PenguinOwl/effect-pedal/Core/Inc/lvgl/src/drivers/README.md

High level drivers for display controllers, frame buffers, etc
