PenguinOwl/effect-pedal/case/effect-pedal - bottom.stl

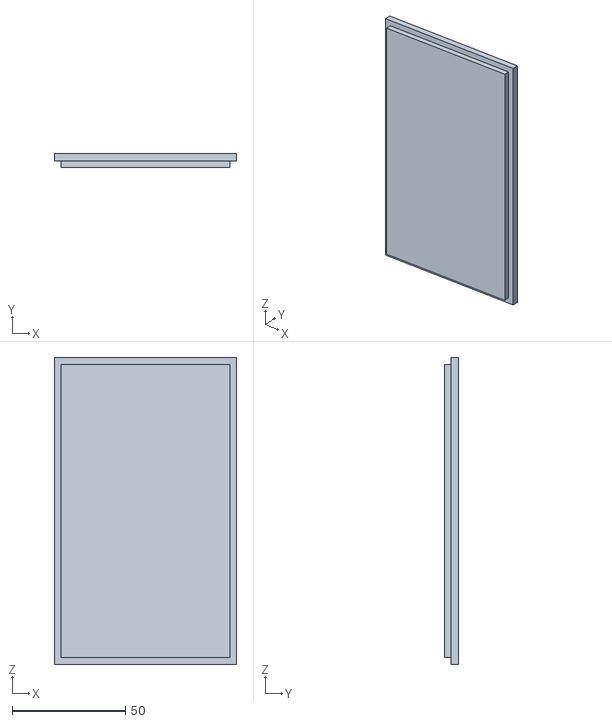
[picture p1: CAD file, 2026-03-07]
case/effect-pedal - bottom.stl
80.5 x 6.38 x 135.7
