PenguinOwl/effect-pedal/kicad-stomp/Models/User Library-Footswich_3PDT.step

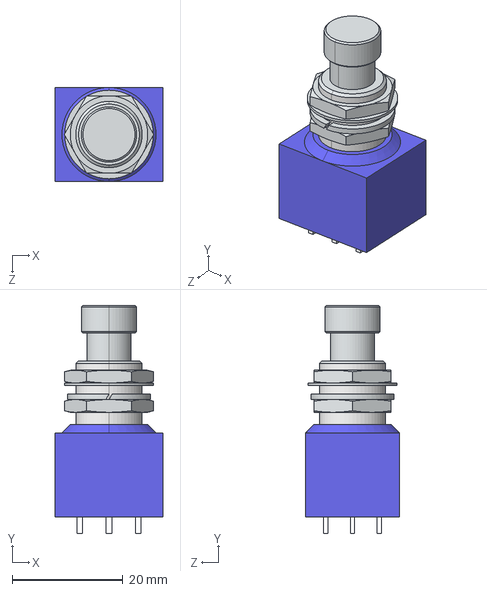
[picture p2: CAD file, 2026-02-17]
kicad-stomp/Models/User Library-Footswich_3PDT.step
19.6 x 41.2 x 17.0 mm
