PenguinOwl/effect-pedal/kicad/effect-pedal.step

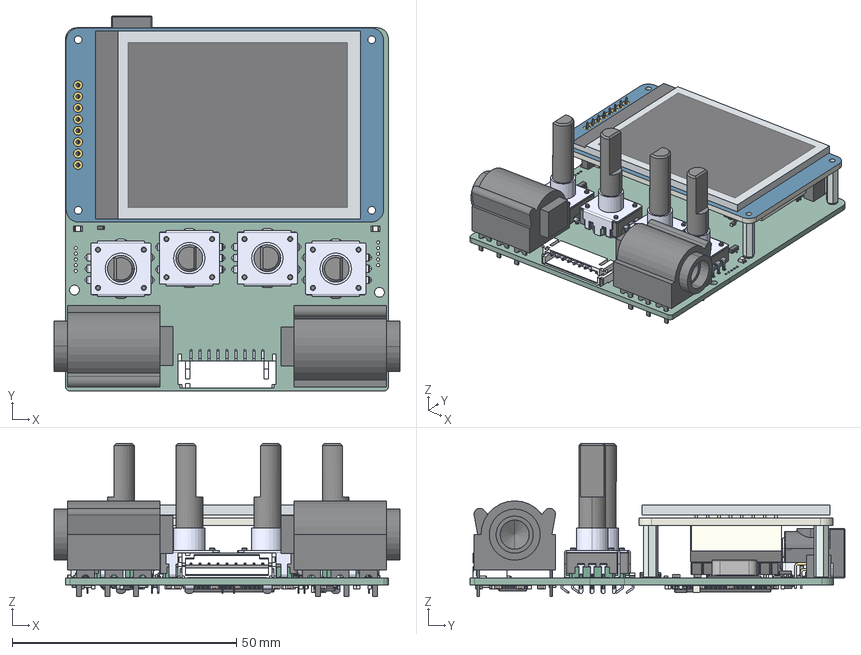
[picture p3: CAD file, 2026-03-07]
kicad/effect-pedal.step
77.1 x 83.6 x 34.2 mm
R_0603_1608Metric x 21
PJ-002AH-SMT-TR_v2
USB4110-GF-A
C_0603_1608Metric x 40
SOT-23 x 2
nmj6hcd3_v2 x 2
SxB-PH-SM4-TB white_9
PEC12R-4230F-S0024 x 4
LED_0805_2012Metric x 2
Crystal_SMD_HC49-SD
20021522-00014xxlfc_v2
SOT-23-6
PinHeader_1x08_P2.54mm_Vertical_SMD_Pin1Right
PinSocket_1x08_P2.54mm_Vertical
TSSOP-20_4.4x6.5mm_P0.65mm
D_SOD-323F x 2
TSOT-23 x 2
LQFP-144_20x20mm_P0.5mm
SOT-23-5
L_1206_3216Metric
BODY-QFN
PIN1-ID
effect-pedal_PCB
