PenguinOwl/effect-pedal/kicad/Models/Same_Sky_TS04-66-65-BK-260-SMT.step

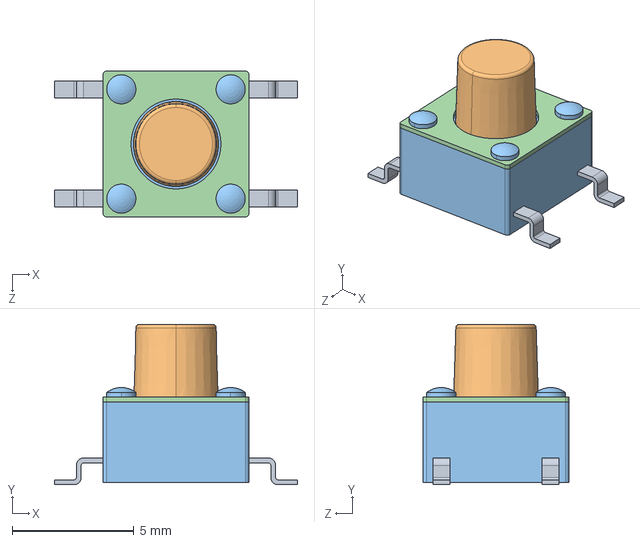
[picture p4: CAD file, 2026-02-21]
kicad/Models/Same_Sky_TS04-66-65-BK-260-SMT.step
10.0 x 6.60 x 6.00 mm
