PenguinOwl/effect-pedal/case/effect-pedal -top.stl

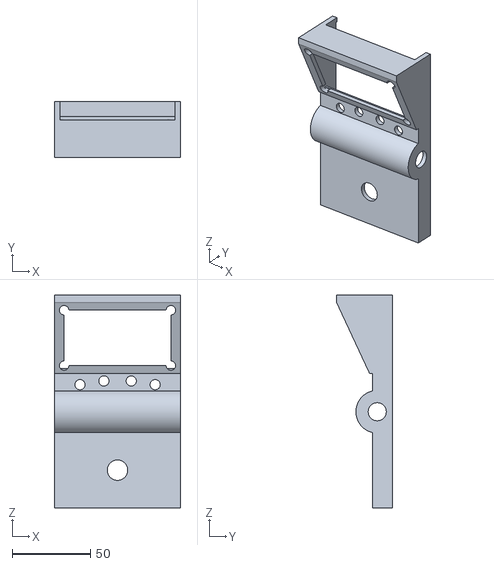
[picture p5: CAD file, 2026-03-07]
case/effect-pedal -top.stl
80.5 x 35.7 x 135.7
