PenguinOwl/effect-pedal/kicad/Models/USB4110-GF-A.stp

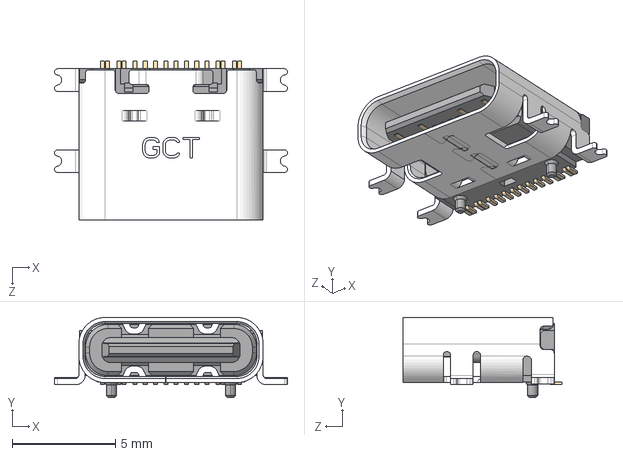
[picture p6: CAD file, 2026-02-20]
kicad/Models/USB4110-GF-A.stp
11.3 x 3.89 x 7.70 mm
