PenguinOwl/effect-pedal/kicad/Models/K01-004K01-2.step

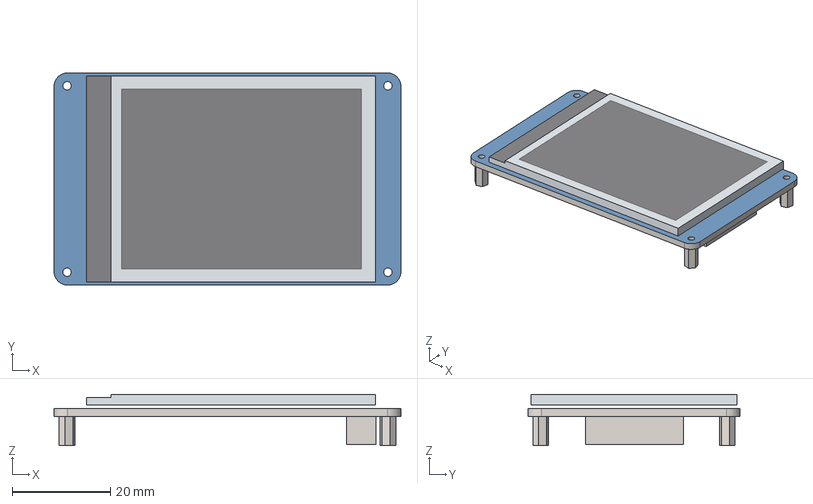
[picture p7: CAD file, 2026-02-20]
kicad/Models/K01-004K01-2.step
70.8 x 43.3 x 10.5 mm
