PenguinOwl/effect-pedal/kicad/Models/nmj6hcd3_v2.stp

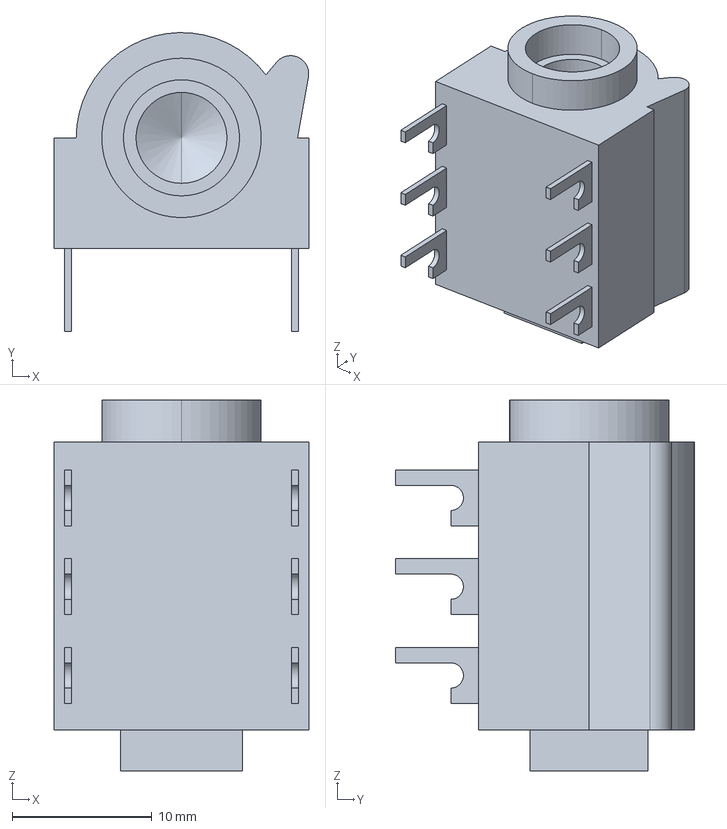
[picture p8: CAD file, 2026-02-20]
kicad/Models/nmj6hcd3_v2.stp
18.2 x 21.4 x 26.5 mm
