PenguinOwl/effect-pedal/kicad/Models/S9B-PH-SM4-TB.STEP

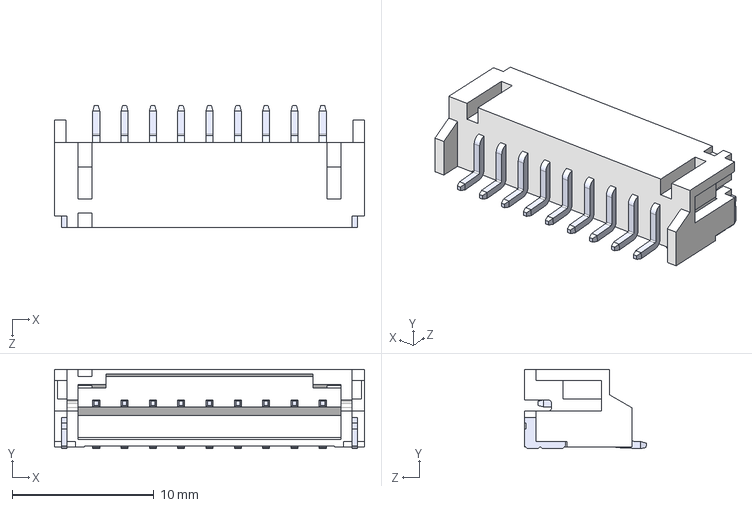
[picture p9: CAD file, 2026-02-20]
kicad/Models/S9B-PH-SM4-TB.STEP
21.9 x 5.60 x 8.60 mm
