PenguinOwl/effect-pedal/kicad/Models/PJ-002AH-SMT-TR_v2.step

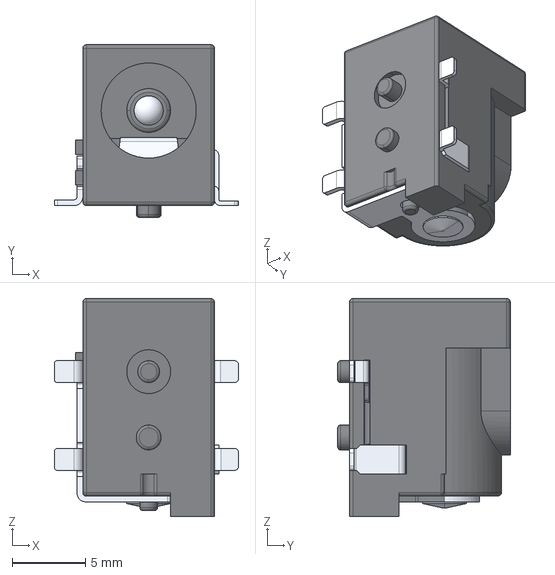
[picture p11: CAD file, 2026-02-20]
kicad/Models/PJ-002AH-SMT-TR_v2.step
12.6 x 11.8 x 14.9 mm
