PenguinOwl/effect-pedal/kicad/Models/PEC12R-4230F-S0024.STEP

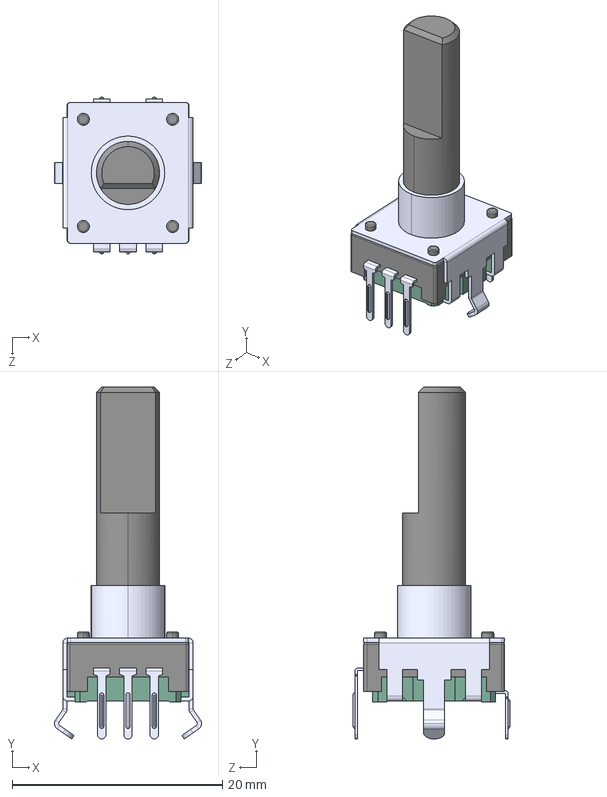
[picture p12: CAD file, 2026-02-20]
kicad/Models/PEC12R-4230F-S0024.STEP
14.0 x 33.5 x 14.9 mm
