PenguinOwl/effect-pedal/kicad/Models/FTSH-107-01-L-DV-K-A.stp

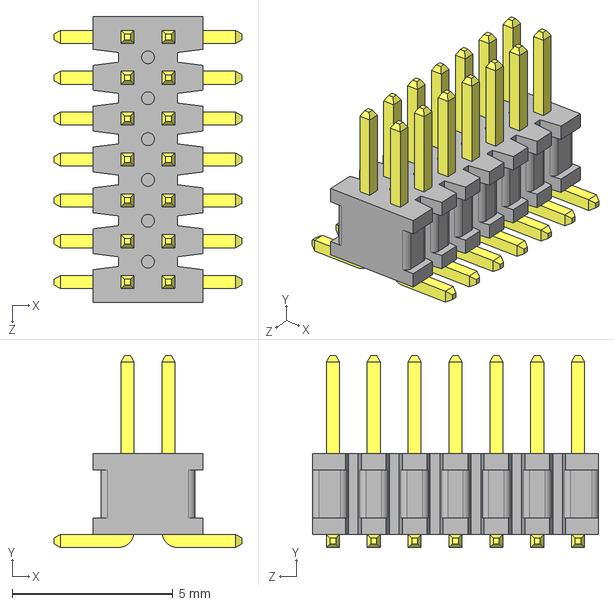
[picture p13: CAD file, 2026-02-19]
kicad/Models/FTSH-107-01-L-DV-K-A.stp
5.84 x 5.97 x 8.89 mm
