PenguinOwl/effect-pedal/kicad/Models/PEC11L-4125F-S0020.stp

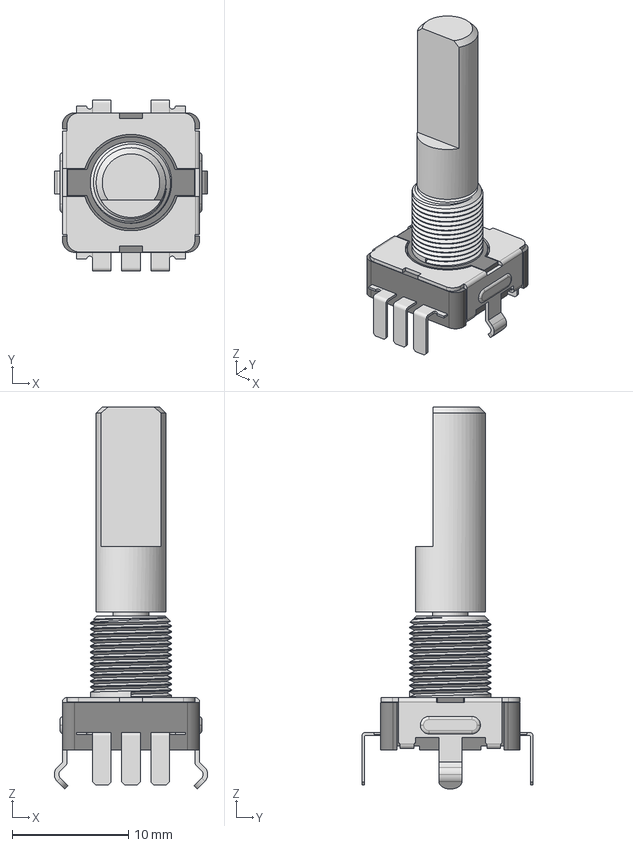
[picture p14: CAD file, 2026-02-18]
kicad/Models/PEC11L-4125F-S0020.stp
13.2 x 14.8 x 32.9 mm
