PenguinOwl/effect-pedal/kicad/Models/PEC12R-4225F-S0024.stp

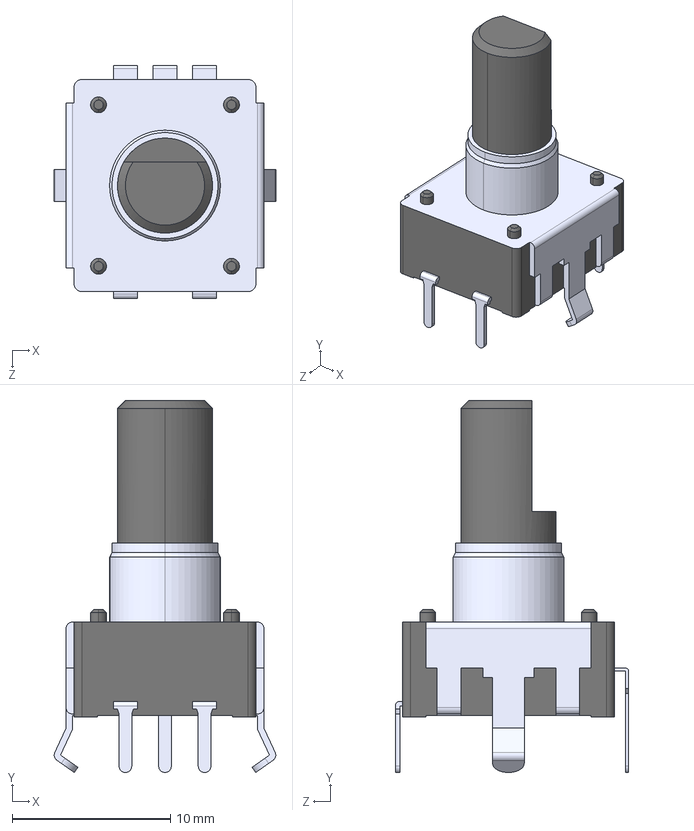
[picture p15: CAD file, 2026-02-18]
kicad/Models/PEC12R-4225F-S0024.stp
14.0 x 23.5 x 14.7 mm
