PenguinOwl/effect-pedal/kicad/Models/PEC11L-4115F-S0020.stp

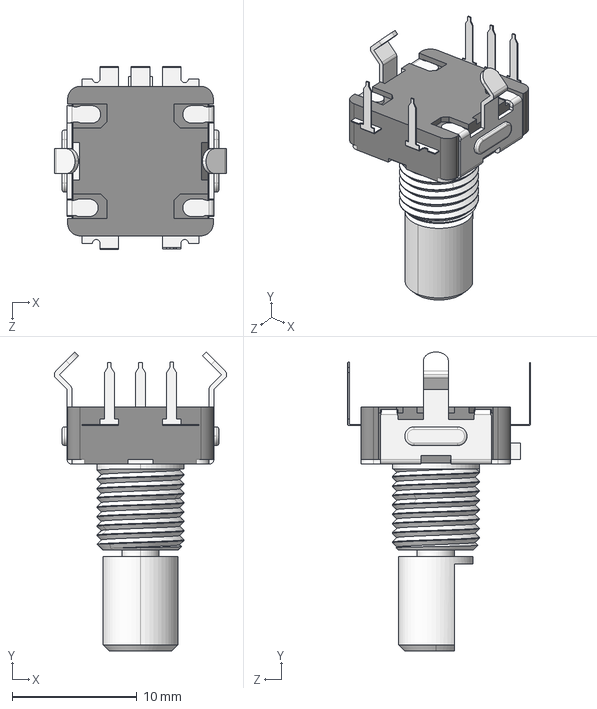
[picture p16: CAD file, 2026-02-17]
kicad/Models/PEC11L-4115F-S0020.stp
13.8 x 24.0 x 14.7 mm
