PenguinOwl/effect-pedal/kicad/Models/PJ-002A.step

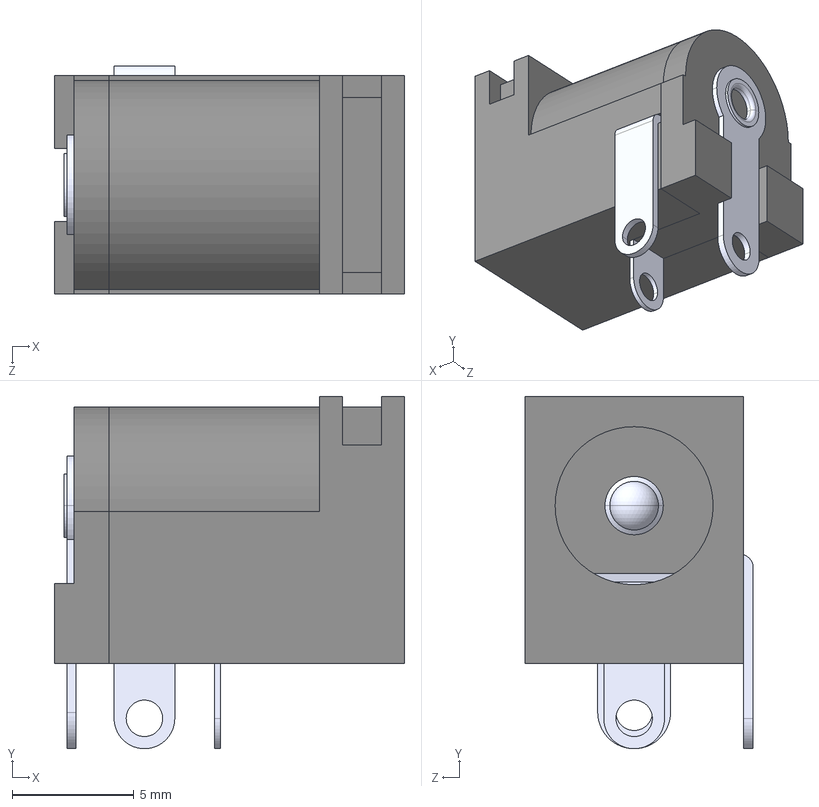
[picture p17: CAD file, 2026-02-17]
kicad/Models/PJ-002A.step
14.4 x 14.5 x 9.40 mm
