PenguinOwl/effect-pedal/(list of files, cad)

Other CAD files:
kicad/Models/nmj6hcd3.stp
kicad/Models/k01-2.stp
kicad/Models/20021522-00014xxlfc.stp
kicad/Models/20021522-00014xxlfc_v2.stp
kicad/Models/PJ-002AH-SMT-TR.step
kicad/Models/TPS62140ARGTR.stp
