PenguinOwl/effect-pedal/kicad/effect-pedal.pdf

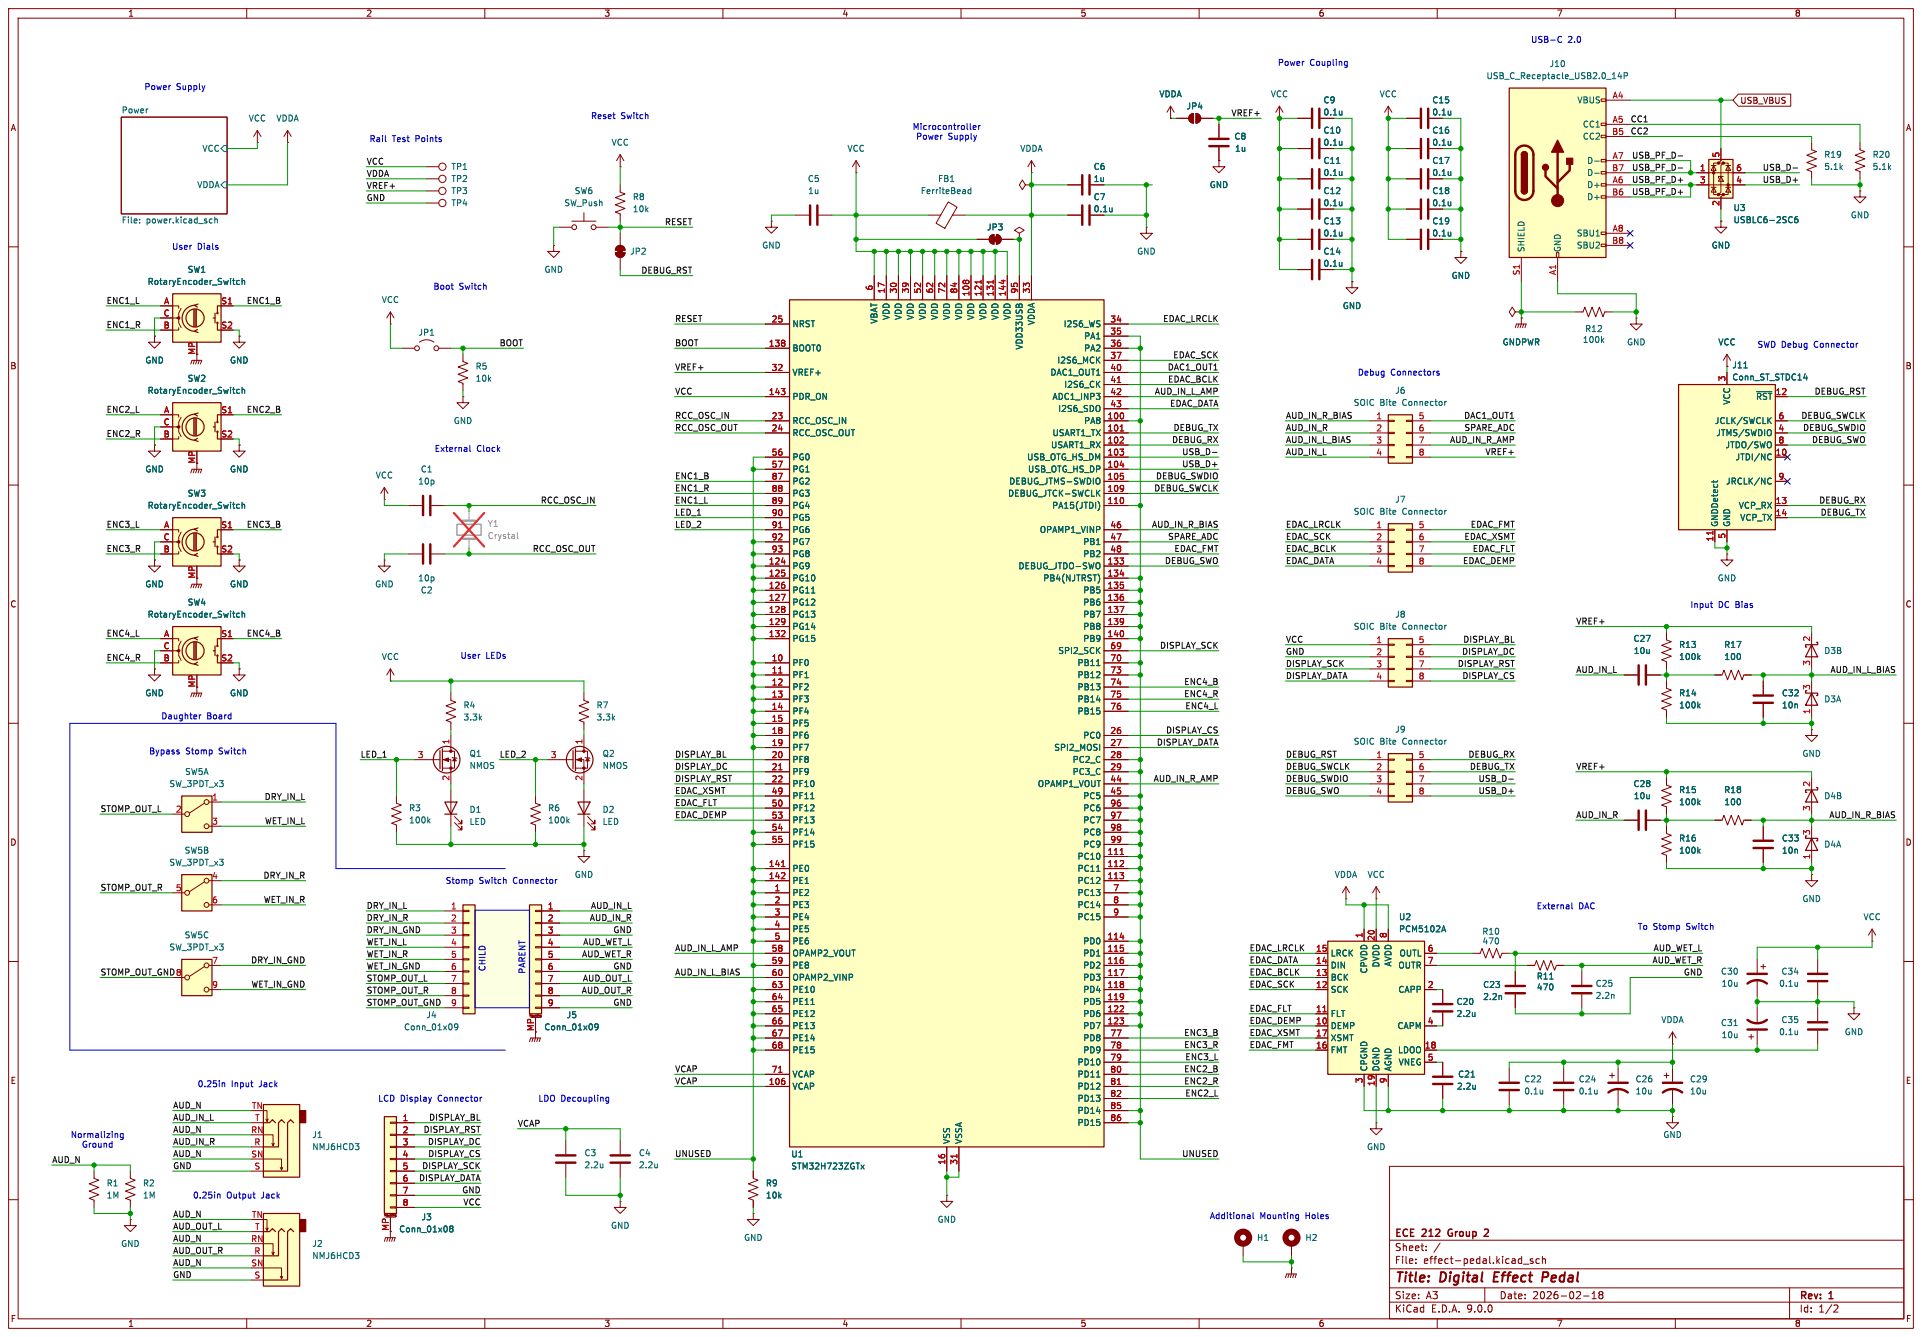
[picture p18: page 1]

Power Supply User Dials
Power File: power.kicad_sch

6 VDD 17 VDD 30 VDD 39 VDD 52 VDD 62 VDD 72 VSS 16 VDD 84 VSSA 31 VDD 108 VDD 121 VDD 131 VDD 144 VDD33USB 95 VDDA 33

J8 SOIC Bite Connector GND

VCC
J9 SOIC Bite Connector GND

9 OUTL 6 OUTR 7 CAPP 2 CAPM 4

Id: 1/2 Title: Digital Effect Pedal File: effect-pedal.kicad_sch Sheet: / ECE 212 Group 2

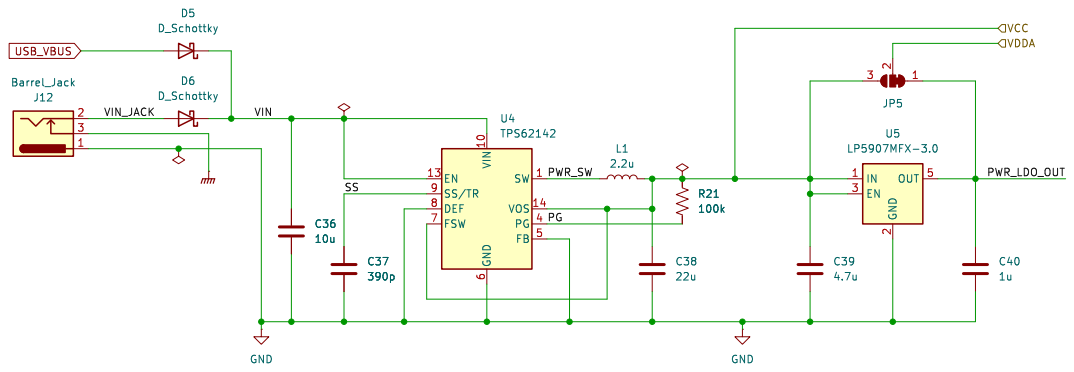
[picture p19: page 2]

6 SW 1 VOS 14 PG 4 FB 5 U4 TPS62142 GND

Id: 2/2 Title: Digital Effect Pedal File: power.kicad_sch Sheet: /Power/ ECE 212 Group 2
