PenguinOwl/effect-pedal/kicad/effect-pedal.kicad_pcb

## KiCad design kicad/effect-pedal.kicad_pcb (2026-03-07)

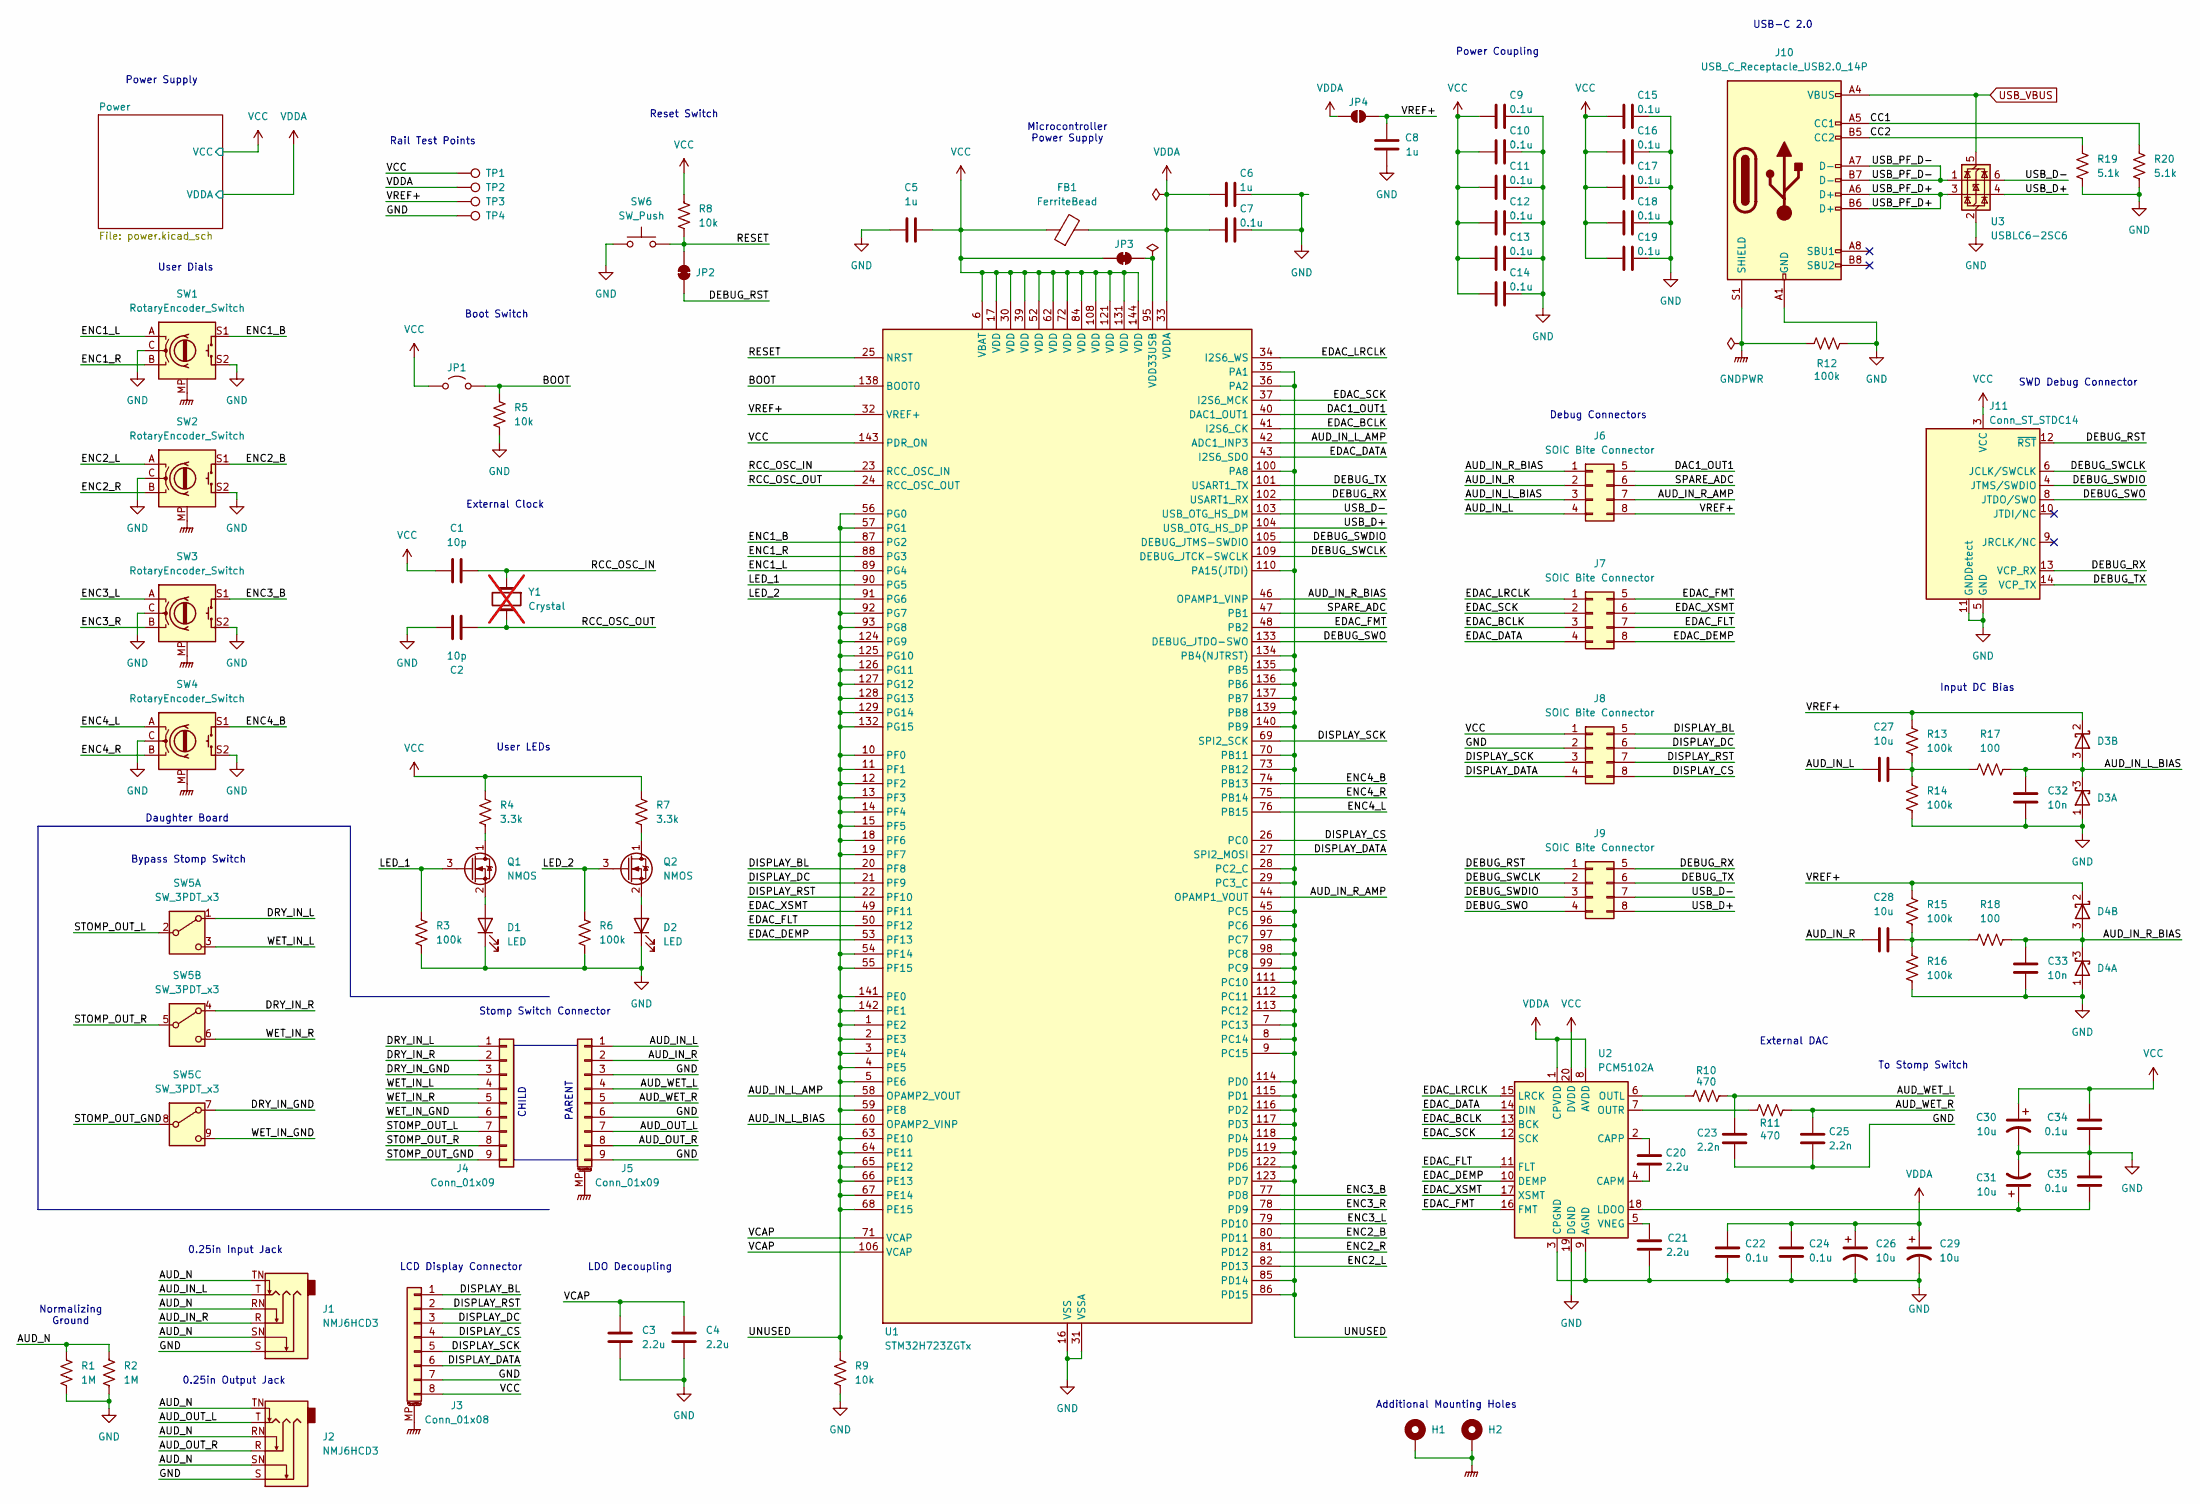
[picture p20: schematic effect-pedal.kicad_sch, Digital Effect Pedal]

Parts:
C1, C2: 10p; C_0603_1608Metric; Part KGM15ACG1E100KT
C3, C4, C20, C21: 2.2u; C_0603_1608Metric; Part Generic
C5, C6, C8: 1u; C_0603_1608Metric; Part Generic
C7, C9, C10, C11, C12, C13, C14, C15, C16, C17, C18, C19, C22, C24, C34, C35: 0.1u; C_0603_1608Metric; Part CL10B104KO8NNNC
C23, C25: 2.2n; C_0603_1608Metric; Part Generic
C26, C27, C28, C29, C30, C31: 10u; C_0603_1608Metric; Part Generic
C32, C33: 10n; C_0603_1608Metric; Part HMJ107BB7103KAHT
D1, D2: LED; LED_0805_2012Metric; Part LTST-C170KRKT
D3, D4: D_Schottky_Dual_Series_ACK_Split; TSOT-23; Part BAT54SFILM
FB1: FerriteBead; L_1206_3216Metric; Part CZP2BFTTE601P
H1, H2: MountingHole_Pad; MountingHole_2.2mm_M2_ISO7380_Pad
J1, J2: NMJ6HCD3; Jack_6.35mm_Neutrik_NMJ6HCD3_Horizontal; Part NMJ6HCD3
J3: Conn_01x08; Waveshare_2.4in_LCD; Part 10129380-908001BLF
J4: Conn_01x09; JST_XH_S9B-XH-A_1x09_P2.50mm_Horizontal; Part Generic
J5: Conn_01x09; JST_PH_S9B-PH-SM4-TB_1x09-1MP_P2.00mm_Horizontal; Part S9B-PH-SM4-TB
J6, J7, J8, J9: SOIC Bite Connector; SOIC_clipProgSmall; Part Generic
J10: USB_C_Receptacle_USB2.0_14P; USB_C_Receptacle_GCT_USB4110; Part USB4110-GF-A
J11: Conn_ST_STDC14; STDC14_Connector; Part 20021512-00014T1LF
JP1: Jumper_2_Open; TestPoint_2Pads_Pitch2.54mm_Drill0.8mm
JP2, JP3: SolderJumper_2_Bridged; SolderJumper-2_P1.3mm_Bridged2Bar_RoundedPad1.0x1.5mm
JP4: SolderJumper_2_Open; SolderJumper-2_P1.3mm_Open_TrianglePad1.0x1.5mm
Q1, Q2: NMOS; SOT-23; Part IRLML6344TRPBF
R1, R2: 1M; R_0603_1608Metric; Part Generic
R3, R6, R12, R13, R14, R15, R16: 100k; R_0603_1608Metric; Part Generic
R4, R7: 3.3k; R_0603_1608Metric; Part Generic
R5, R8, R9: 10k; R_0603_1608Metric; Part Generic
R10, R11: 470; R_0603_1608Metric; Part Generic
R17, R18: 100; R_0603_1608Metric; Part Generic
R19, R20: 5.1k; R_0603_1608Metric; Part Generic
SW1, SW2, SW3, SW4: RotaryEncoder_Switch; RotaryEncoder_Bourns_Vertical_PEC12R-3x17F-Sxxxx; Part PEC12R-4225F-S0024
SW5: SW_3PDT_x3
SW6: SW_Push; SW_Push_1P1T_NO_E-Switch_TL3301NxxxxxG; Part TS04-66-65-BK-260-SMT
TP1, TP2, TP3, TP4: TestPoint; TestPoint_Pad_2.0x2.0mm
U1: STM32H723ZGTx; LQFP-144_20x20mm_P0.5mm; Part STM32H723ZGT6
U2: PCM5102A; TSSOP-20_4.4x6.5mm_P0.65mm; Part PCM5102AQPWRQ1
U3: USBLC6-2SC6; SOT-23-6; Part USBLC6-2SC6
Y1: Crystal; Crystal_SMD_HC49-SD; not fitted

Connections:
/AUD_IN_L: C27.1, J1.T, J5.1, J6.4
/AUD_IN_L_AMP: U1.42 (ADC1_INP3), U1.58 (OPAMP2_VOUT)
/AUD_IN_L_BIAS: C32.2, D3.3 (K), J6.3, R17.2, U1.60 (OPAMP2_VINP)
/AUD_IN_R: C28.1, J1.R, J5.2, J6.2
/AUD_IN_R_AMP: J6.7, U1.44 (OPAMP1_VOUT)
/AUD_IN_R_BIAS: C33.2, D4.3 (K), J6.1, R18.2, U1.46 (OPAMP1_VINP)
/AUD_N: J1.RN, J1.SN, J1.TN, J2.RN, J2.SN, J2.TN, R1.1, R2.1
/AUD_OUT_L: J2.T, J5.7
/AUD_OUT_R: J2.R, J5.8
/AUD_WET_L: C23.2, J5.4, R10.1
/AUD_WET_R: C25.2, J5.5, R11.1
/BOOT: JP1.2 (B), R5.1, U1.138 (BOOT0)
/CC1: J10.A5 (CC1), R20.1
/CC2: J10.B5 (CC2), R19.1
/DAC1_OUT1: J6.5, U1.40 (DAC1_OUT1)
/DEBUG_RST: J9.1, J11.12 (~RST), JP2.1 (A)
/DEBUG_RX: J9.5, J11.13 (VCP_RX), U1.102 (USART1_RX)
/DEBUG_SWCLK: J9.2, J11.6 (JCLK/SWCLK), U1.109 (DEBUG_JTCK-SWCLK)
/DEBUG_SWDIO: J9.3, J11.4 (JTMS/SWDIO), U1.105 (DEBUG_JTMS-SWDIO)
/DEBUG_SWO: J9.4, J11.8 (JTDO/SWO), U1.133 (DEBUG_JTDO-SWO)
/DEBUG_TX: J9.6, J11.14 (VCP_TX), U1.101 (USART1_TX)
/DISPLAY_BL: J3.1, J8.5, U1.20 (PF8)
/DISPLAY_CS: J3.4, J8.8, U1.26 (PC0)
/DISPLAY_DATA: J3.6, J8.4, U1.27 (SPI2_MOSI)
/DISPLAY_DC: J3.3, J8.6, U1.21 (PF9)
/DISPLAY_RST: J3.2, J8.7, U1.22 (PF10)
/DISPLAY_SCK: J3.5, J8.3, U1.69 (SPI2_SCK)
/EDAC_BCLK: J7.3, U1.41 (I2S6_CK), U2.13 (BCK)
/EDAC_DATA: J7.4, U1.43 (I2S6_SDO), U2.14 (DIN)
/EDAC_DEMP: J7.8, U1.53 (PF13), U2.10 (DEMP)
/EDAC_FLT: J7.7, U1.50 (PF12), U2.11 (FLT)
/EDAC_FMT: J7.5, U1.48 (PB2), U2.16 (FMT)
/EDAC_LRCLK: J7.1, U1.34 (I2S6_WS), U2.15 (LRCK)
/EDAC_SCK: J7.2, U1.37 (I2S6_MCK), U2.12 (SCK)
/EDAC_XSMT: J7.6, U1.49 (PF11), U2.17 (XSMT)
/ENC1_B: SW1.S1, U1.87 (PG2)
/ENC1_L: SW1.A, U1.89 (PG4)
/ENC1_R: SW1.B, U1.88 (PG3)
/ENC2_B: SW2.S1, U1.80 (PD11)
/ENC2_L: SW2.A, U1.82 (PD13)
/ENC2_R: SW2.B, U1.81 (PD12)
/ENC3_B: SW3.S1, U1.77 (PD8)
/ENC3_L: SW3.A, U1.79 (PD10)
/ENC3_R: SW3.B, U1.78 (PD9)
/ENC4_B: SW4.S1, U1.74 (PB13)
/ENC4_L: SW4.A, U1.76 (PB15)
/ENC4_R: SW4.B, U1.75 (PB14)
/LED_1: Q1.3 (G), R3.1, U1.90 (PG5)
/LED_2: Q2.3 (G), R6.1, U1.91 (PG6)
/RCC_OSC_IN: C1.2, U1.23 (RCC_OSC_IN), Y1.1
/RCC_OSC_OUT: C2.1, U1.24 (RCC_OSC_OUT), Y1.2
/RESET: JP2.2 (B), R8.2, SW6.2, U1.25 (NRST)
/SPARE_ADC: J6.6, U1.47 (PB1)
/UNUSED: R9.1, U1.1 (PE2), U1.2 (PE3), U1.3 (PE4), U1.4 (PE5), U1.5 (PE6), U1.7 (PC13), U1.8 (PC14), U1.9 (PC15), U1.10 (PF0), U1.11 (PF1), U1.12 (PF2), U1.13 (PF3), U1.14 (PF4), U1.15 (PF5), U1.18 (PF6), U1.19 (PF7), U1.28 (PC2_C), U1.29 (PC3_C), U1.35 (PA1), U1.36 (PA2), U1.45 (PC5), U1.54 (PF14), U1.55 (PF15), U1.56 (PG0), U1.57 (PG1), U1.59 (PE8), U1.63 (PE10), U1.64 (PE11), U1.65 (PE12), U1.66 (PE13), U1.67 (PE14), U1.68 (PE15), U1.70 (PB11), U1.73 (PB12), U1.85 (PD14), U1.86 (PD15), U1.92 (PG7), U1.93 (PG8), U1.96 (PC6), U1.97 (PC7), U1.98 (PC8), U1.99 (PC9), U1.100 (PA8), U1.110 (PA15(JTDI)), U1.111 (PC10), U1.112 (PC11), U1.113 (PC12), U1.114 (PD0), U1.115 (PD1), U1.116 (PD2), U1.117 (PD3), U1.118 (PD4), U1.119 (PD5), U1.122 (PD6), U1.123 (PD7), U1.124 (PG9), U1.125 (PG10), U1.126 (PG11), U1.127 (PG12), U1.128 (PG13), U1.129 (PG14), U1.132 (PG15), U1.134 (PB4(NJTRST)), U1.135 (PB5), U1.136 (PB6), U1.137 (PB7), U1.139 (PB8), U1.140 (PB9), U1.141 (PE0), U1.142 (PE1)
/USB_D+: J9.8, U1.104 (USB_OTG_HS_DP), U3.4 (I/O2)
/USB_D-: J9.7, U1.103 (USB_OTG_HS_DM), U3.6 (I/O1)
/USB_PF_D+: J10.A6 (D+), J10.B6 (D+), U3.3 (I/O2)
/USB_PF_D-: J10.A7 (D-), J10.B7 (D-), U3.1 (I/O1)
/VCAP: C3.1, C4.1, U1.71 (VCAP), U1.106 (VCAP)
/VREF+: C8.2, D3.2 (K), D4.2 (K), J6.8, JP4.2 (B), R13.1, R15.1, TP3.1, U1.32 (VREF+)
GND: C2.2, C3.2, C4.2, C5.2, C6.2, C7.2, C8.1, C9.2, C10.2, C11.2, C12.2, C13.2, C14.2, C15.2, C16.2, C17.2, C18.2, C19.2, C21.1, C22.2, C23.1, C24.2, C25.1, C26.2, C29.2, C30.2, C31.2, C32.1, C33.1, C34.2, C35.1, D1.1 (K), D2.1 (K), D3.1 (A), D4.1 (A), J1.S, J2.S, J3.7, J5.3, J5.6, J5.9, J8.2, J10.A1 (GND), J10.A12 (GND), J10.B1 (GND), J10.B12 (GND), J11.5 (GND), J11.7 (GND), J11.11 (GNDDetect), R1.2, R2.2, R3.2, R5.2, R6.2, R9.2, R12.2, R14.2, R16.2, R19.2, R20.2, SW1.C, SW1.S2, SW2.C, SW2.S2, SW3.C, SW3.S2, SW4.C, SW4.S2, SW6.1, TP4.1, U1.16 (VSS), U1.31 (VSSA), U1.38 (VSS), U1.51 (VSS), U1.61 (VSS), U1.83 (VSS), U1.94 (VSS), U1.107 (VSS), U1.120 (VSS), U1.130 (VSS), U2.3 (CPGND), U2.9 (AGND), U2.19 (DGND), U3.2 (GND); also elsewhere on the board
GNDPWR: H1.1, H2.1, J3.MP (MountPin), J5.MP (MountPin), J10.S1 (SHIELD), R12.1, SW1.MP, SW2.MP, SW3.MP, SW4.MP; also elsewhere on the board
unnamed: C27.2, R13.2, R14.1, R17.1
unnamed: C28.2, R15.2, R16.1, R18.1
unnamed: D1.2 (A), Q1.2 (S)
unnamed: D2.2 (A), Q2.2 (S)
unnamed: J4.1, SW5.1 (A)
unnamed: J4.2, SW5.4 (A)
unnamed: J4.3, SW5.7 (A)
unnamed: J4.4, SW5.3 (C)
unnamed: J4.5, SW5.6 (C)
unnamed: J4.6, SW5.9 (C)
unnamed: J4.7, SW5.2 (B)
unnamed: J4.8, SW5.5 (B)
unnamed: J4.9, SW5.8 (B)
unnamed: JP3.2 (B), U1.95 (VDD33USB)
unnamed: Q1.1 (D), R4.2
unnamed: Q2.1 (D), R7.2
unnamed: C20.1, U2.4 (CAPM)
unnamed: C20.2, U2.2 (CAPP)
unnamed: C31.1, C35.2, U2.18 (LDOO)
unnamed: R10.2, U2.6 (OUTL)
unnamed: R11.2, U2.7 (OUTR)
unnamed: C21.2, U2.5 (VNEG)
USB_VBUS: J10.A4 (VBUS), J10.A9 (VBUS), J10.B4 (VBUS), J10.B9 (VBUS), U3.5 (VBUS); also elsewhere on the board
VCC: C1.1, C5.1, C9.1, C10.1, C11.1, C12.1, C13.1, C14.1, C15.1, C16.1, C17.1, C18.1, C19.1, C30.1, C34.1, FB1.1, J3.8, J8.1, J11.3 (VCC), JP1.1 (A), JP3.1 (A), R4.1, R7.1, R8.1, TP1.1, U1.6 (VBAT), U1.17 (VDD), U1.30 (VDD), U1.39 (VDD), U1.52 (VDD), U1.62 (VDD), U1.72 (VDD), U1.84 (VDD), U1.108 (VDD), U1.121 (VDD), U1.131 (VDD), U1.143 (PDR_ON), U1.144 (VDD), U2.20 (DVDD); also elsewhere on the board
VDDA: C6.1, C7.1, C22.1, C24.1, C26.1, C29.1, FB1.2, JP4.1 (A), TP2.1, U1.33 (VDDA), U2.1 (CPVDD), U2.8 (AVDD); also elsewhere on the board

Notes on the sheet:
Normalizing Ground
Input DC Bias
CHILD
Microcontroller Power Supply
Boot Switch
SWD Debug Connector
Additional Mounting Holes
Power Supply
External DAC
Stomp Switch Connector
Debug Connectors
PARENT
LCD Display Connector
0.25in Input Jack
Daughter Board
USB-C 2.0
Reset Switch
To Stomp Switch
External Clock
LDO Decoupling
User Dials
0.25in Output Jack
Bypass Stomp Switch
Power Coupling
User LEDs
Rail Test Points

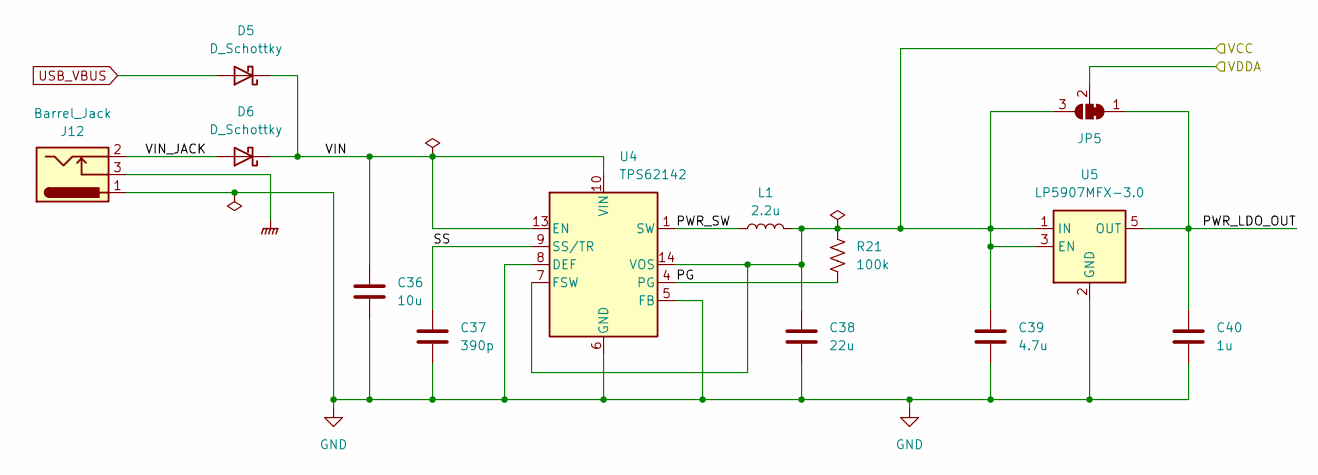
[picture p21: schematic power.kicad_sch, Digital Effect Pedal]

Parts:
C36: 10u; C_0603_1608Metric; Part Generic
C37: 390p; C_0603_1608Metric; Part C0603C391J5GAC
C38: 22u; C_0603_1608Metric; Part KAM21AT70J226KU
C39: 4.7u; C_0603_1608Metric; Part C1608X7S0G475M080AC
C40: 1u; C_0603_1608Metric; Part Generic
D5, D6: D_Schottky; D_SOD-323F; Part GSGP0240SD
J12: Barrel_Jack; CUI_PJ-002AH-SMT-TR; Part PJ-002AH-SMT-TR
JP5: SolderJumper_3_Bridged12; SolderJumper-3_P1.3mm_Bridged12_Pad1.0x1.5mm
L1: 2.2u; L_Vishay_IHLP-1212; Part MPX1D1250L2R2
R21: 100k; R_0603_1608Metric; Part Generic
U4: TPS62142; VQFN-16-1EP_3x3mm_P0.5mm_EP1.68x1.68mm_ThermalVias; Part TPS62142RGTR
U5: LP5907MFX-3.0; SOT-23-5; Part LP5907MFX-3.0

Connections:
/Power/PG: R21.2, U4.4 (PG)
/Power/PWR_LDO_OUT: C40.1, JP5.1 (A), U5.5 (OUT)
/Power/PWR_SW: L1.1, U4.1 (SW), U4.2 (SW), U4.3 (SW)
/Power/SS: C37.1, U4.9 (SS/TR)
/Power/VIN: C36.1, D5.1 (K), D6.1 (K), U4.10 (VIN), U4.11 (VIN), U4.12 (VIN), U4.13 (EN)
/Power/VIN_JACK: D6.2 (A), J12.2
GND: C36.2, C37.2, C38.2, C39.2, C40.2, J12.1, U4.5 (FB), U4.6 (GND), U4.8 (DEF), U4.15 (GND), U4.16 (GND), U4.17 (GND), U5.2 (GND); also elsewhere on the board
GNDPWR: J12.3; also elsewhere on the board
USB_VBUS: D5.2 (A); also elsewhere on the board
VCC: C38.1, C39.1, JP5.3 (B), L1.2, R21.1, U4.7 (FSW), U4.14 (VOS), U5.1 (IN), U5.3 (EN); also elsewhere on the board
VDDA: JP5.2 (C); also elsewhere on the board

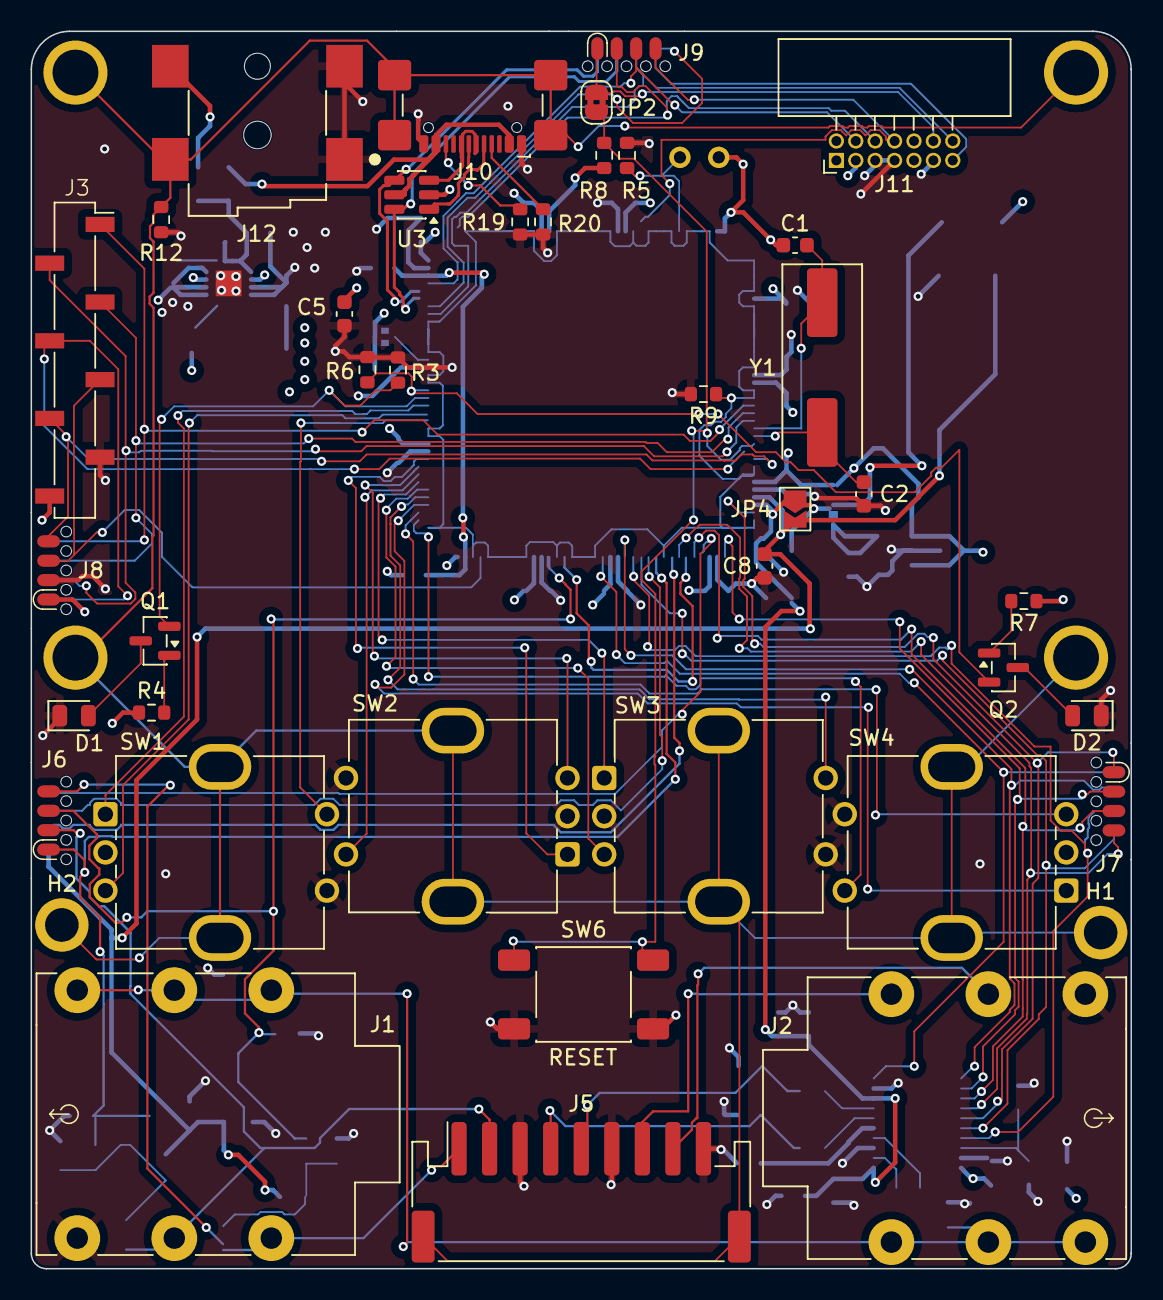
[picture p22: board effect-pedal.kicad_pcb from above]

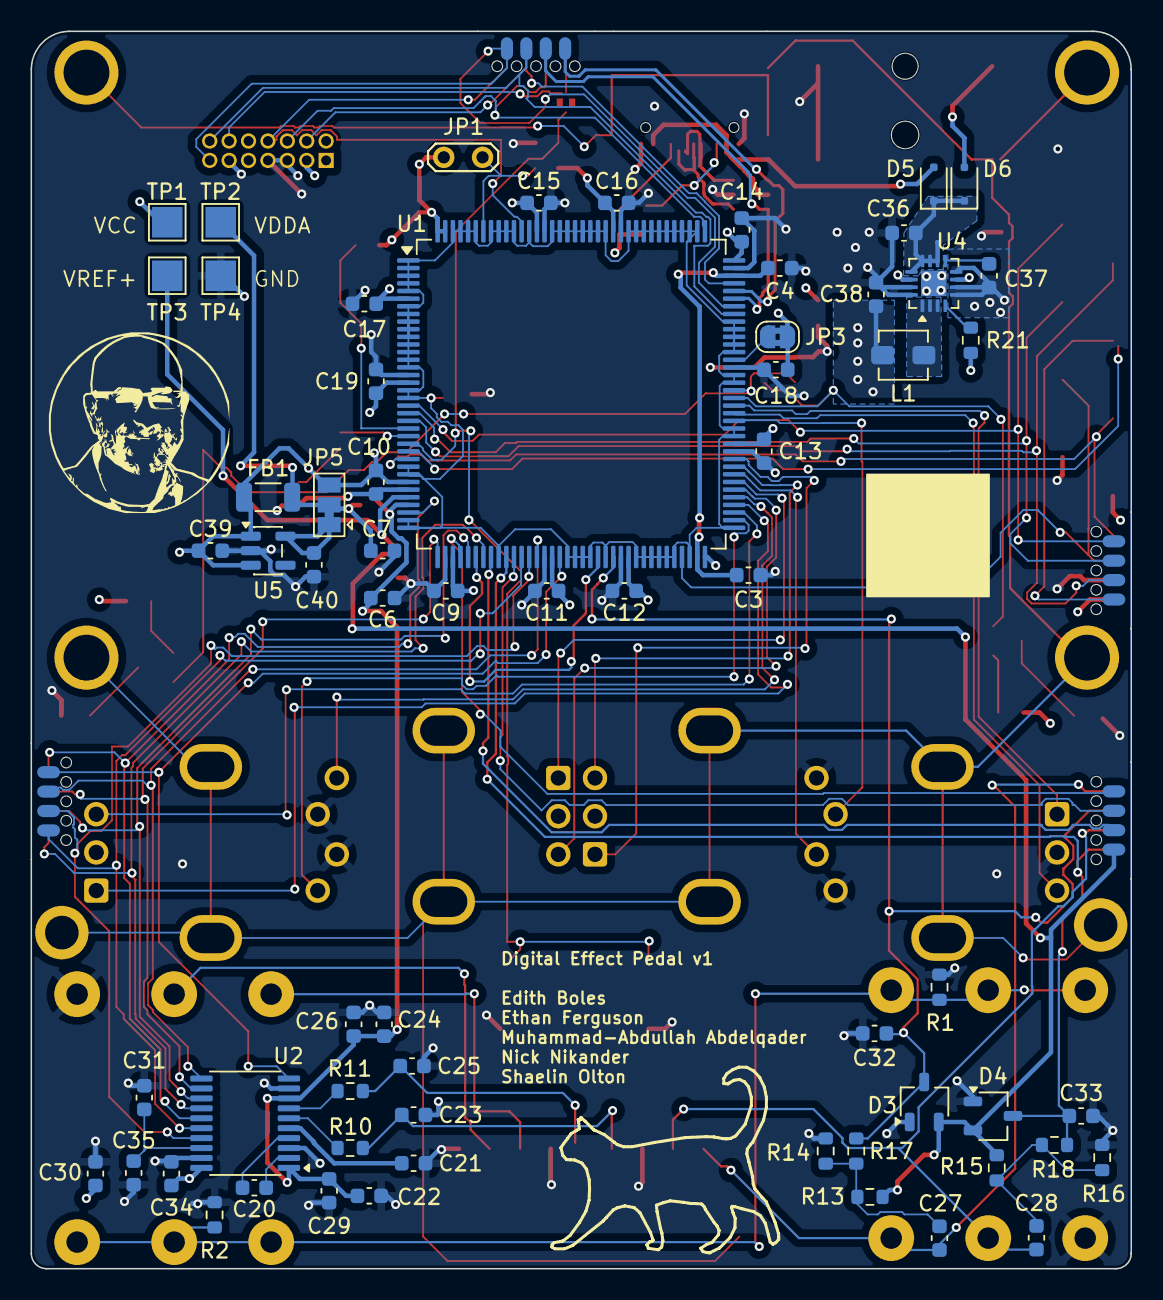
[picture p23: board effect-pedal.kicad_pcb from below]

Board: 4 copper layers, 72.0 x 81.0 mm, 104 parts (64 on the bottom side), 84 nets.
