PenguinOwl/effect-pedal/Core/Src/main.c

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
/* Includes ------------------------------------------------------------------*/
#include "main.h"
#include "usb_device.h"

/* USER CODE BEGIN Includes */
#include "lvgl/lvgl.h"
#include "encoders.h"
#include "screen.h"
/* USER CODE END Includes */

/* USER CODE BEGIN PD */
#define LCD_H_RES       240
#define LCD_V_RES       320
#define BUS_SPI2_POLL_TIMEOUT HAL_MAX_DELAY
#define LCD_BUF_SIZE    LCD_H_RES * LCD_V_RES / 10

// Delay settings
#define SAMPLE_RATE 48000
#define DELAY_MS   300
#define DELAY_SAMPLES ((SAMPLE_RATE * DELAY_MS) / 1000)
#define MAX_DELAY 75000   // 1 sec
/* USER CODE END PD */

ADC_HandleTypeDef hadc1;
DMA_HandleTypeDef hdma_adc1;

DAC_HandleTypeDef hdac1;

I2S_HandleTypeDef hi2s6;
DMA_HandleTypeDef hdma_spi6_tx;

OPAMP_HandleTypeDef hopamp1;
OPAMP_HandleTypeDef hopamp2;

SPI_HandleTypeDef hspi2;
DMA_HandleTypeDef hdma_spi2_tx;

TIM_HandleTypeDef htim1;
TIM_HandleTypeDef htim2;
TIM_HandleTypeDef htim3;
TIM_HandleTypeDef htim4;

UART_HandleTypeDef huart1;

/* USER CODE BEGIN PV */
uint32_t adc_buf[4];
BDMA_BUFFER uint16_t dac_buf[4];

lv_color_t lcd_buf1[LCD_BUF_SIZE];
lv_color_t lcd_buf2[LCD_BUF_SIZE];

lv_display_t *lcd_disp;
lv_obj_t *label;
lv_obj_t *label_vals;
volatile int lcd_bus_busy = 0;
uint8_t text_needs_update = 0;
uint8_t fft_needs_update = 0;
// double vol_mod = 0.0;

int16_t delay_buffer[MAX_DELAY];
uint32_t delay_index = 0;

int32_t feedback = 16000;   // 0.5 in Q15
int32_t mix      = 16000;   // 0.5 in Q15
int32_t delay    = 48000;
float gain = 0.0;
float ngain = 0.0;
/* USER CODE END PV */

void SystemClock_Config(void);
static void MPU_Config(void);
static void MX_GPIO_Init(void);
static void MX_DMA_Init(void);
static void MX_BDMA_Init(void);
static void MX_ADC1_Init(void);
static void MX_TIM2_Init(void);
static void MX_DAC1_Init(void);
static void MX_OPAMP2_Init(void);
static void MX_SPI2_Init(void);
static void MX_OPAMP1_Init(void);
static void MX_TIM3_Init(void);
static void MX_TIM4_Init(void);
static void MX_I2S6_Init(void);
static void MX_USART1_UART_Init(void);
static void MX_TIM1_Init(void);
/* USER CODE BEGIN 0 */
int32_t clamp(int32_t a, int32_t b, int32_t c) {
	if (a > c)
		return c;
	if (a < b)
		return b;
	return a;
}

void update_parameters() {
	ngain = 0.2 * get_encoders()[0].spin_buf + 0.0;
	gain = pow(10, ngain / 10);
	if (get_encoders()[0].pressed)
		get_encoders()[0].spin_buf = 0;
	mix = get_encoders()[1].spin_buf * 32767 / 30 + 32767;
	mix = clamp(mix, 0, 32767);
	if (get_encoders()[1].pressed)
		get_encoders()[1].spin_buf = 0;
	delay = get_encoders()[2].spin_buf * 48000 / 30 + 48000;
	delay = clamp(delay, 0, MAX_DELAY);
	if (get_encoders()[2].pressed_time > 1000)
		get_encoders()[2].spin_buf = 0;
	feedback = get_encoders()[3].spin_buf * 32767 / 30 + 32767 / 2;
	feedback = clamp(feedback, 0, 32767);
	if (get_encoders()[3].pressed)
		get_encoders()[3].spin_buf = 0;
}

static inline int16_t q15_mul(int16_t a, int16_t b)
{
    return (int16_t)(((int32_t)a * b) >> 15);
}

int32_t process_audio_delay(int32_t input) {

	    // Read delayed sample
	    int32_t delayed = delay_buffer[delay_index];

	    // Compute new sample to store (input + feedback * delayed)
	    int32_t fb = q15_mul(delayed, feedback);
	    int32_t write_sample = input + fb;

	    delay_buffer[delay_index] = (int16_t)write_sample;

	    // Increment circular index
	    delay_index++;
	    if (delay_index >= delay)
	        delay_index = 0;

	    // Mix dry + wet
	    int32_t wet  = delayed;
	    int32_t dry  = input;

	    int32_t wet_scaled = q15_mul(wet, mix);
	    int32_t dry_scaled = q15_mul(dry, (32767 - mix));

	    int32_t output = wet_scaled + dry_scaled;

	    output *= gain;

	    return output;

}

uint16_t process_audio(uint32_t in) {
	uint32_t mid = 0xffff >> 1;
	int32_t diff = in - mid;
	// diff *= vol_mod;
	diff = process_audio_delay(diff);
	uint16_t res = diff + mid;
	res ^= (1 << 15);
	return res;
}

void HAL_ADC_ConvHalfCpltCallback(ADC_HandleTypeDef *hadc) {

	dac_buf[0] = process_audio(adc_buf[0]);
	dac_buf[1] = process_audio(adc_buf[1]);
	HAL_I2S_Transmit_DMA(&hi2s6, dac_buf, 2);
}

void HAL_ADC_ConvCpltCallback(ADC_HandleTypeDef *hadc) {

	dac_buf[2] = process_audio(adc_buf[2]);
	dac_buf[3] = process_audio(adc_buf[2]);
	HAL_I2S_Transmit_DMA(&hi2s6, dac_buf + 2, 2);
}

void lcd_color_transfer_ready_cb(SPI_HandleTypeDef *hspi) {
	/* CS high */
	HAL_GPIO_WritePin(DISPLAY_CS_GPIO_Port, DISPLAY_CS_Pin, GPIO_PIN_SET);
	lcd_bus_busy = 0;
	lv_display_flush_ready(lcd_disp);
}

/* Initialize LCD I/O bus, reset LCD */
static int32_t lcd_io_init(void) {
	/* Register SPI Tx Complete Callback */
	HAL_SPI_RegisterCallback(&hspi2, HAL_SPI_TX_COMPLETE_CB_ID,
			lcd_color_transfer_ready_cb);

	/* reset LCD */
	HAL_GPIO_WritePin(DISPLAY_RST_GPIO_Port, DISPLAY_RST_Pin, GPIO_PIN_RESET);
	HAL_Delay(100);
	HAL_GPIO_WritePin(DISPLAY_RST_GPIO_Port, DISPLAY_RST_Pin, GPIO_PIN_SET);
	HAL_Delay(100);

	HAL_GPIO_WritePin(DISPLAY_CS_GPIO_Port, DISPLAY_CS_Pin, GPIO_PIN_SET);
	HAL_GPIO_WritePin(DISPLAY_DC_GPIO_Port, DISPLAY_DC_Pin, GPIO_PIN_SET);

	return HAL_OK;
}

/* Platform-specific implementation of the LCD send command function. In general this should use polling transfer. */
static void lcd_send_cmd(lv_display_t *disp, const uint8_t *cmd,
		size_t cmd_size, const uint8_t *param, size_t param_size) {
	LV_UNUSED(disp);
	while (lcd_bus_busy)
		; /* wait until previous transfer is finished */
	/* Set the SPI in 8-bit mode */
	hspi2.Init.DataSize = SPI_DATASIZE_8BIT;
	HAL_SPI_Init(&hspi2);
	/* DCX low (command) */
	HAL_GPIO_WritePin(DISPLAY_DC_GPIO_Port, DISPLAY_DC_Pin, GPIO_PIN_RESET);
	/* CS low */
	HAL_GPIO_WritePin(DISPLAY_CS_GPIO_Port, DISPLAY_CS_Pin, GPIO_PIN_RESET);
	/* send command */
	if (HAL_SPI_Transmit(&hspi2, cmd, cmd_size, BUS_SPI2_POLL_TIMEOUT)
			== HAL_OK) {
		/* DCX high (data) */
		HAL_GPIO_WritePin(DISPLAY_DC_GPIO_Port, DISPLAY_DC_Pin, GPIO_PIN_SET);
		/* for short data blocks we use polling transfer */
		HAL_SPI_Transmit(&hspi2, (uint8_t*) param, (uint16_t) param_size,
				BUS_SPI2_POLL_TIMEOUT);
		/* CS high */
		HAL_GPIO_WritePin(DISPLAY_CS_GPIO_Port, DISPLAY_CS_Pin, GPIO_PIN_SET);
	}
}

/* Platform-specific implementation of the LCD send color function. For better performance this should use DMA transfer.
 * In case of a DMA transfer a callback must be installed to notify LVGL about the end of the transfer.
 */
static void lcd_send_color(lv_display_t *disp, const uint8_t *cmd,
		size_t cmd_size, uint8_t *param, size_t param_size) {
	LV_UNUSED(disp);
	while (lcd_bus_busy)
		; /* wait until previous transfer is finished */
	/* Set the SPI in 8-bit mode */
	hspi2.Init.DataSize = SPI_DATASIZE_8BIT;
	HAL_SPI_Init(&hspi2);
	/* DCX low (command) */
	HAL_GPIO_WritePin(DISPLAY_DC_GPIO_Port, DISPLAY_DC_Pin, GPIO_PIN_RESET);
	/* CS low */
	HAL_GPIO_WritePin(DISPLAY_CS_GPIO_Port, DISPLAY_CS_Pin, GPIO_PIN_RESET);
	/* send command */
	if (HAL_SPI_Transmit(&hspi2, cmd, cmd_size, BUS_SPI2_POLL_TIMEOUT)
			== HAL_OK) {
		/* DCX high (data) */
		HAL_GPIO_WritePin(DISPLAY_DC_GPIO_Port, DISPLAY_DC_Pin, GPIO_PIN_SET);
		/* for color data use DMA transfer */
		/* Set the SPI in 16-bit mode to match endianness */
		hspi2.Init.DataSize = SPI_DATASIZE_16BIT;
		HAL_SPI_Init(&hspi2);
		lcd_bus_busy = 1;
		HAL_SPI_Transmit_DMA(&hspi2, param, (uint16_t) param_size / 2);
		/* NOTE: CS will be reset in the transfer ready callback */
	}
}

void update_text() {
	text_needs_update = 1;
}

void update_fft() {
	fft_needs_update = 1;
}
/* USER CODE END 0 */

/**
  * @brief  The application entry point.
  * @retval int
  */
int main(void)
{

  /* MPU Configuration--------------------------------------------------------*/
  MPU_Config();

  /* MCU Configuration--------------------------------------------------------*/

  /* Reset of all peripherals, Initializes the Flash interface and the Systick. */
  HAL_Init();

  /* Configure the system clock */
  SystemClock_Config();

  /* Initialize all configured peripherals */
  MX_GPIO_Init();
  MX_DMA_Init();
  MX_BDMA_Init();
  MX_ADC1_Init();
  MX_TIM2_Init();
  MX_DAC1_Init();
  MX_OPAMP2_Init();
  MX_SPI2_Init();
  MX_OPAMP1_Init();
  MX_TIM3_Init();
  MX_TIM4_Init();
  MX_I2S6_Init();
  MX_USART1_UART_Init();
  MX_USB_DEVICE_Init();
  MX_TIM1_Init();
  /* USER CODE BEGIN 2 */
	HAL_OPAMP_SelfCalibrate(&hopamp1);
	HAL_OPAMP_SelfCalibrate(&hopamp2);
	HAL_OPAMP_Start(&hopamp1);
	HAL_OPAMP_Start(&hopamp2);
	//HAL_OPAMP_SelfCalibrate(&hopamp1);
	//HAL_OPAMP_SelfCalibrate(&hopamp2);
	HAL_TIM_Base_Start_IT(&htim2);
	HAL_DAC_Start(&hdac1, DAC_CHANNEL_1);
	HAL_ADCEx_Calibration_Start(&hadc1, ADC_CALIB_OFFSET_LINEARITY,
			ADC_SINGLE_ENDED);
	HAL_ADC_Start_DMA(&hadc1, adc_buf, 4);

	init_encoders();
	HAL_TIM_Base_Start_IT(&htim4);

	lv_init();
	lcd_io_init();
	lv_tick_set_cb(HAL_GetTick);

	lcd_disp = lv_ili9341_create(LCD_H_RES, LCD_V_RES, LV_LCD_FLAG_NONE,
			lcd_send_cmd, lcd_send_color);
	lv_display_set_rotation(lcd_disp, LV_DISPLAY_ROTATION_270);
	lv_display_set_buffers(lcd_disp, lcd_buf1, lcd_buf2, LCD_BUF_SIZE,
			LV_DISPLAY_RENDER_MODE_PARTIAL);

	//ui_init(lcd_disp);
	lv_obj_set_style_bg_color(lv_screen_active(), lv_color_hex(0x003a57),
			LV_PART_MAIN);

	Screen_Init();

	label = lv_label_create(lv_screen_active());
	lv_obj_set_style_text_font(label, &lv_font_montserrat_14, 0);
	lv_obj_set_style_text_color(lv_screen_active(), lv_color_hex(0xffffff),
			LV_PART_MAIN);
	lv_label_set_text(label, "GAIN:\nW/D:\nDELAY:\nFDBK:");
	lv_obj_align(label, LV_ALIGN_CENTER, 50, -70);

	label_vals = lv_label_create(lv_screen_active());
	lv_obj_set_style_text_font(label_vals, &lv_font_montserrat_14, 0);
	lv_label_set_text(label_vals, "");
	lv_obj_align(label_vals, LV_ALIGN_CENTER, 115, -70);

	HAL_TIM_Base_Start_IT(&htim1);
	HAL_TIM_Base_Start_IT(&htim3);
  /* USER CODE END 2 */

  /* Infinite loop */
  /* USER CODE BEGIN WHILE */
	while (1) {
		if (fft_needs_update) {
			fft_needs_update = 0;
		}
		if (text_needs_update) {
			Compute_FFT();
			Screen_Update();
			lv_label_set_text_fmt(
					label_vals,
					"%.2f dB\n%.0f%%\n%li ms\n%.0f%%",
					ngain,
					(float) mix / 32767 * 100,
					delay / 48,
					(float) feedback / 32767 * 100);
			text_needs_update = 0;
		}

		lv_timer_handler();
    /* USER CODE END WHILE */

    /* USER CODE BEGIN 3 */
	}
  /* USER CODE END 3 */
}

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
 /* MPU Configuration */

void MPU_Config(void)
{
  MPU_Region_InitTypeDef MPU_InitStruct = {0};

  /* Disables the MPU */
  HAL_MPU_Disable();

  /** Initializes and configures the Region and the memory to be protected
  */
  MPU_InitStruct.Enable = MPU_REGION_ENABLE;
  MPU_InitStruct.Number = MPU_REGION_NUMBER0;
  MPU_InitStruct.BaseAddress = 0x0;
  MPU_InitStruct.Size = MPU_REGION_SIZE_4GB;
  MPU_InitStruct.SubRegionDisable = 0x87;
  MPU_InitStruct.TypeExtField = MPU_TEX_LEVEL0;
  MPU_InitStruct.AccessPermission = MPU_REGION_NO_ACCESS;
  MPU_InitStruct.DisableExec = MPU_INSTRUCTION_ACCESS_DISABLE;
  MPU_InitStruct.IsShareable = MPU_ACCESS_SHAREABLE;
  MPU_InitStruct.IsCacheable = MPU_ACCESS_NOT_CACHEABLE;
  MPU_InitStruct.IsBufferable = MPU_ACCESS_NOT_BUFFERABLE;

  HAL_MPU_ConfigRegion(&MPU_InitStruct);
  /* Enables the MPU */
  HAL_MPU_Enable(MPU_PRIVILEGED_DEFAULT);

}

/**
  * @brief  This function is executed in case of error occurrence.
  * @retval None
  */
void Error_Handler(void)
{
  /* USER CODE BEGIN Error_Handler_Debug */
	/* User can add his own implementation to report the HAL error return state */
	__disable_irq();
	while (1) {
	}
  /* USER CODE END Error_Handler_Debug */
}
#ifdef USE_FULL_ASSERT
/**
  * @brief  Reports the name of the source file and the source line number
  *         where the assert_param error has occurred.
  * @param  file: pointer to the source file name
  * @param  line: assert_param error line source number
  * @retval None
  */
void assert_failed(uint8_t *file, uint32_t line)
{
  /* USER CODE BEGIN 6 */
  /* User can add his own implementation to report the file name and line number,
     ex: printf("Wrong parameters value: file %s on line %d\r\n", file, line) */
  /* USER CODE END 6 */
}
#endif /* USE_FULL_ASSERT */
