PenguinOwl/effect-pedal/effect-pedal.ioc

Mcu.UserName=STM32H723ZGTx
PA0.GPIO_Label=EDAC_LRCLK
PA0.Signal=I2S6_WS
PA10.Signal=USART1_RX
PA11.Signal=USB_OTG_HS_DM
PA12.Signal=USB_OTG_HS_DP
PA13(JTMS/SWDIO).Signal=DEBUG_JTMS-SWDIO
PA14(JTCK/SWCLK).Signal=DEBUG_JTCK-SWCLK
PA3.GPIO_Label=EDAC_SCK
PA3.Signal=GPIO_Output
PA4.Signal=COMP_DAC11_group
PA5.GPIO_Label=EDAC_BCLK
PA5.Signal=I2S6_CK
PA6.Signal=ADCx_INP3
PA7.GPIO_Label=EDAC_DOUT
PA7.Signal=I2S6_SDO
PB0.Signal=OPAMP1_VINP
PB10.GPIO_Label=DISPLAY_SCK
PB10.Signal=SPI2_SCK
PB13.GPIO_Label=ENC4_B
PB13.Signal=GPIO_Input
PB14.GPIO_Label=ENC4_R
PB14.Signal=GPIO_Input
PB15.GPIO_Label=ENC4_L
PB15.Signal=GPIO_Input
PB2.GPIO_Label=EDAC_FMT
PB2.Signal=GPIO_Output
PB3(JTDO/TRACESWO).Signal=DEBUG_JTDO-SWO
PB6.Signal=USART1_TX
PC0.GPIO_Label=DISPLAY_CS
PC0.Signal=GPIO_Output
PC1.GPIO_Label=DISPLAY_DATA
PC1.Signal=SPI2_MOSI
PC4.Signal=OPAMP1_VOUT
PD10.GPIO_Label=ENC3_L
PD10.Signal=GPIO_Input
PD11.GPIO_Label=ENC2_B
PD11.Signal=GPIO_Input
PD12.GPIO_Label=ENC2_R
PD12.Signal=GPIO_Input
PD13.GPIO_Label=ENC2_L
PD13.Signal=GPIO_Input
PD8.GPIO_Label=ENC3_B
PD8.Signal=GPIO_Input
PD9.GPIO_Label=ENC3_R
PD9.Signal=GPIO_Input
PE7.Signal=OPAMP2_VOUT
PE9.Signal=OPAMP2_VINP
PF10.GPIO_Label=DISPLAY_RST
PF10.Signal=GPIO_Output
PF11.GPIO_Label=EDAC_XSMT
PF11.Signal=GPIO_Output
PF12.GPIO_Label=EDAC_FLT
PF12.Signal=GPIO_Output
PF13.GPIO_Label=EDAC_DEMP
PF13.Signal=GPIO_Output
PF8.GPIO_Label=DISPLAY_BL
PF8.Signal=GPIO_Output
PF9.GPIO_Label=DISPLAY_DC
PF9.Signal=GPIO_Output
PG2.GPIO_Label=ENC1_B
PG2.Signal=GPIO_Input
PG3.GPIO_Label=ENC1_R
PG3.Signal=GPIO_Input
PG4.GPIO_Label=ENC1_L
PG4.Signal=GPIO_Input
PG5.GPIO_Label=LED_1
PG5.Signal=GPIO_Output
PG6.GPIO_Label=LED_2
PG6.Signal=GPIO_Output
PH0-OSC_IN.Signal=RCC_OSC_IN
PH1-OSC_OUT.Signal=RCC_OSC_OUT
