PenguinOwl/effect-pedal/(commit log)

2026-02-02 remake project
    [pins.csv]
2026-02-04 Add encoder demo
2026-02-07 Add kicad project
    [effect-pedal.kicad_pcb, effect-pedal.kicad_sch]
2026-02-11 Prep for schematic
2026-02-11 Start schematic
2026-02-11 Upload correct kicad project
    [effect-pedal.kicad_sch, power.kicad_sch]
2026-02-11 Labelled #pins
    [effect-pedal.kicad_sch]
2026-02-13 wire up aud in jack
    [effect-pedal.kicad_sch]
2026-02-13 start to DAC wiring
    [effect-pedal.kicad_sch]
2026-02-13 Add power caps
    [effect-pedal.kicad_sch]
2026-02-14 Clean up schematic
    [effect-pedal.kicad_sch]
2026-02-16 Wiring on DAC pwr lines
    [effect-pedal.kicad_sch]
2026-02-16 usb stuff & display label changes
    [effect-pedal.kicad_sch]
2026-02-17 Finish basic schematic
    [effect-pedal.kicad_sch, power.kicad_sch]
2026-02-17 Start remapping of pins for I2S6
    [effect-pedal.kicad_sch]
2026-02-17 Finish schematic and start assigning footprints
    [PEC11L-4115F-S0020.stp, PJ-002A.step, User Library-Footswich_3PDT.step, effect-pedal.kicad_pcb, effect-pedal.kicad_sch, power.kicad_sch, stomp-board.kicad_pcb, stomp-board.kicad_sch]
2026-02-18 Prodfiles for stomp
    [stomp-board.kicad_pcb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]
2026-02-18 DNP markers
    [effect-pedal.kicad_sch]
2026-02-18 Add more part numbers and VDDA regulator
    [PEC11L-4125F-S0020.stp, PEC12R-4225F-S0024.stp, effect-pedal.kicad_sch, power.kicad_sch]
2026-02-18 Add more parts
    [effect-pedal.kicad_sch, power.kicad_sch]
2026-02-19 Finish part sourcing and start PCB layout
    [FTSH-107-01-L-DV-K-A.stp, PJ-002AH-SMT-TR.stp, effect-pedal.kicad_pcb, effect-pedal.kicad_sch, power.kicad_sch]
2026-02-20 Finish schematic
    [20021522-00014xxlfc.stp, 20021522-00014xxlfc_v2.stp, K01-004K01-2.step, K01-004K01-2_v2.step, PEC12R-4230F-S0024.STEP, PJ-002AH-SMT-TR.step, PJ-002AH-SMT-TR_v2.step, S9B-PH-SM4-TB.STEP]
2026-02-21 Setup for production
    [Same_Sky_TS04-66-65-BK-260-SMT.step, TPS62140ARGTR.stp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]
2026-02-27 Plot schematic pdf
2026-02-28 Add ibom
    [effect-pedal.kicad_sch, power.kicad_sch]
2026-03-01 Support the board and BDMA
2026-03-01 Remove debug noise scaling
    [main.c]
2026-03-02 Update FFT to read from dac
    [effect-pedal.kicad_pcb]
2026-03-03 Added Delay Effect
    Defined the delay settings, allocated delay buffer, added feedback and mix parameters, added process_audio_fft function which creates a delay loop, called from normal process_audio function.
    Note * Changed ADC1 to 1 channel; Number of conversions = 1. With 2 channels the ADC values were messed up and the audio output was turning on/off or ticking
2026-03-03 Revert "Added Delay Effect"
    This reverts commit 31df361a8eaab517668d6a041f7feeb787219462.
    [effect-pedal.ioc, main.c, main.h]
2026-03-03 Revert ADC1 back to 2 Channels
    Number of conversions = 2, Rank 1:Channel 3, Rank 2:Channel 4. DAC buffer address 0/1 are read from ADC buffer 0. DAC buffer address 2/3 are read from ADC buffer address 2.
    [effect-pedal.ioc, main.c]
2026-03-03 Added FFT Timer
2026-03-13 [WIP] Add encoder functions for effect
